p14c31355/psp3000-internal-mod/cad/references/orangepi-zero2w/opi24pin.png

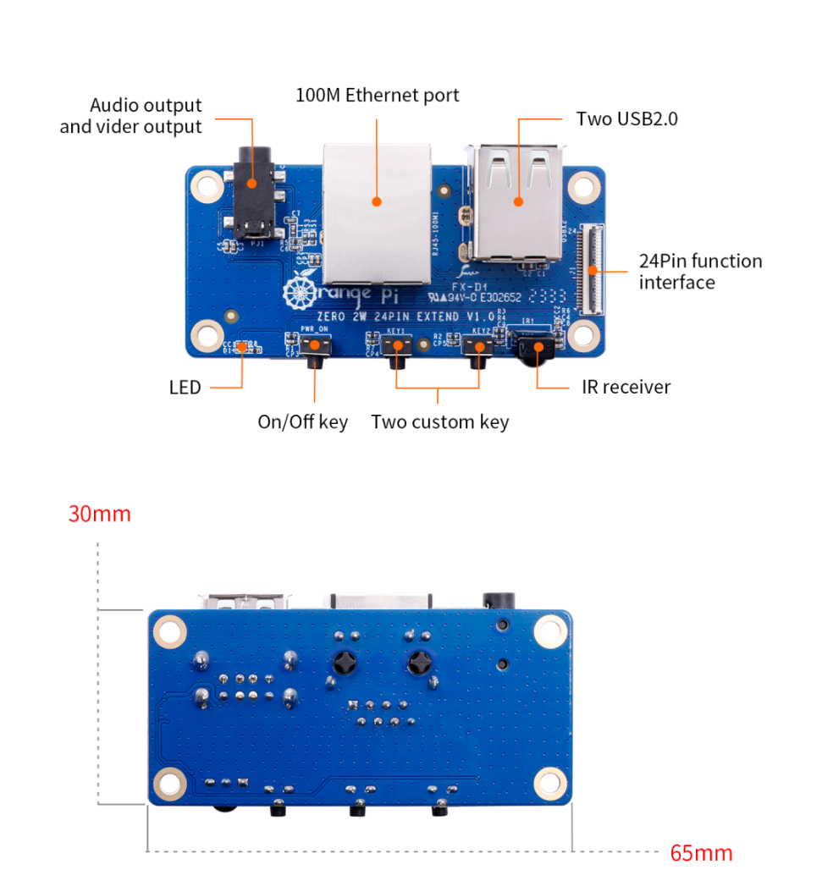
cad/references/orangepi-zero2w/opi24pin.png
