p14c31355/psp3000-internal-mod/README.md

# psp3000-internal-mod
PSP-3000 internal SBC, display adapter, power, USB-C, PCB and mechanical integration project.
