p14c31355/psp3000-internal-mod/docs/photo-analysis-donor-shell-drop2.md

# Donor shell photo analysis — drop 2 (2026-10-15 afternoon batch)

All 7 photos shot 2026-10-15 (13:50–14:00 JST), DOOGEE Note58 Pro,
4672x3504, mm stainless ruler in-frame throughout.  Files live in
`~/dev/p20-root/shots/` (not in repo).  All values PHOTO-ESTIMATED
(±2-3 mm through projection) unless marked otherwise.

## Shot inventory (drop 2)

| File | View | Key content |
|---|---|---|
| 135234_13722 | board side | MB, speaker left, UMD opening right (analyzed in drop 1) |
| 135241_13723 | battery side | battery bay, UMD cavity opening (drop 1) |
| 135248_13724 | **depth measurement** | ruler inserted vertically into the UMD bay opening, battery pack (PSP-S110 3.6V 1200mAh, label legible) still installed |
| 135255_13725 | **depth measurement #2** | ruler held vertically against the inner frame, reads ~30 mm at the white frame's depth edge |
| 140026_13726 | **skeleton FRONT shell** | clear replacement front face panel, new-in-bag, display window + button holes visible, width ~170 mm on ruler |
| 140033_13727 | skeleton front shell, other angle | same part; ribs and bosses visible THROUGH the clear plastic; central large circular rib structure |
| 140039_13728 | skeleton front shell, third angle | same part; blue circular ring accent at center, ~Ø50 mm at the 50–100 mm band |

## Findings

### 1. Depth measurements (U1/U2 — first real numbers)

- **13724**: ruler zero at the table plane, the 20 mm mark aligns with
  the body's rear outer surface → total body thickness ~19-20 mm,
  consistent with the 18.6 mm spec (photo-projection tolerance).  The
  lower part of the ruler (0-15) is inside the UMD bay — the visible
  numbers resume only above the shell.  This shot establishes the
  method works; a dedicated depth-of-cavity shot (0 at cavity floor,
  number at the door-trough ceiling) is the missing variant.
- **13725**: ruler against the inner frame reads the white chassis
  depth at **~30 mm band edge ≈ 30 mm** — this is the inner frame's
  vertical extent at that point, i.e. the internal z-space at the
  battery-side region is on the order of the spec's interior height.

### 2. Skeleton front shell (replacement, new) — high value for U12/U13

- Clear reproduction front panel confirmed purchased and in hand.
- **Display window**: large rounded rectangle, centered; edge
  reflections prevent exact bezel-width reading from these angles.
- **Internal structure visible through the clear plastic**: grid ribs
  and cylindrical bosses; a large **circular rib structure at the
  center** (13727) and a **blue circular ring accent ~Ø50 mm**
  (13728) at the 50-100 mm ruler band.
- Body width ~160-170 mm consistent across all three skeleton shots.
- SONY logo appears reversed through the clear plastic (viewed from
  the inside).
- Mechanical value: the skeleton's rib/boss pattern, seen from
  outside, gives the front-shell internal structure map without
  disassembly — the U12 aperture depth and U13 bezel questions can be
  narrowed with a straight-on window close-up + a ruler lying across
  the window edge.

### 3. Battery pack (13724)

- Label legible: **PSP-S110, 3.6 V, 1200 mAh, SONY** — the pack family
  is confirmed exactly (was previously "S110 class" inference).
- Pack still installed during the depth measurement.

## Updated measurement asks

1. **Cavity depth shot, done right**: ruler zero INSIDE the UMD cavity
   at its floor, reading at the door-trough ceiling plane (13724 got
   the method but the scale inside was hidden — retry with the ruler
   pushed so a graduation lands at the floor, or use the skeleton
   shell as a straightedge).
2. **Display window straight-on close-up** through the skeleton shell
   with the ruler across the window edge (bezel width + window W×H)
   — U13.
3. Same shot series with the ruler against the window's inner step if
   visible — U12.

All findings above are recorded as ESTIMATED; no manufacturing
constraint uses them yet.
