p14c31355/psp3000-internal-mod/cad/params.md

# PSP-3000 mechanical parameters (single source of truth for CAD)

Conventions:
- Units: millimeters.
- Coordinate system: X right, Y up, origin at bottom-left corner of the
  front face (LCD side), Z toward viewer (out of the screen). Body outline
  = the outer silhouette projected on XY.
- Every value carries provenance class:
  VERIFIED_FROM_PRIMARY_SOURCE (VPS) / VERIFIED_FROM_RELIABLE_SOURCE (VRS)
  / MEASURED / DERIVED / ESTIMATED / UNKNOWN.
- This file is consumed by cad/psp3000_model.py. Values marked ESTIMATED
  or UNKNOWN are rendered as explicitly flagged geometry or left hollow;
  they never silently become manufacturing constraints.

## Body envelope

param | value | class | source
---|---|---|---
BODY_W | 169.4 | VPS | Sony/SCEE PSP-3000 official product overview (WxDxH 169.4x18.6x71.4)
BODY_D | 71.4 | VPS | same
BODY_H | 18.6 | VPS | same (excludes largest projection)
BODY_CORNER_R | 6.0 | ESTIMATED | rounded-corner radius, visual estimate; refine from donor photos
SHELL_T | UNKNOWN | UNKNOWN | wall thickness, needs donor measurement (U1)

## LCD module (panel only; face glass/bezel separate)

param | value | class | source
---|---|---|---
LCD_W | 103.6 | VPS | Sharp LCM-09006 Table 5
LCD_H | 64.35 | VPS | same
LCD_T | 2.2 | VPS | same
LCD_ACTIVE_W | 95.04 | VPS | same
LCD_ACTIVE_H | 53.856 | VPS | same
LCD_X | UNKNOWN | UNKNOWN | X position of panel center; needs donor measurement (U1/m1.6)
LCD_Y | UNKNOWN | UNKNOWN | Y position of panel center; same
LCD_FPC_EXIT | UNKNOWN | UNKNOWN | which edge + position the 31-pin FPC exits; donor photo (m1.6)

## Battery

param | value | class | source
---|---|---|---
BAT_W | 58.7 | VRS | vendor listing PSP-S110 (2.31 in)
BAT_D | 36.0 | VRS | vendor listing (1.42 in)
BAT_T | 10.2 | VRS | vendor listing (0.4 in)
BAT_POS | UNKNOWN | UNKNOWN | battery pocket position; donor (m1.5)

## UMD cavity

param | value | class | source
---|---|---|---
UMD_CAVITY | UNKNOWN | UNKNOWN | full extent after drive removal (U2); donor measurement campaign 1
UMD_DOOR_CLEAR | UNKNOWN | UNKNOWN | min clearance to closed door (U2)

## Screw bosses

param | value | class | source
---|---|---|---
BOSS_XY | UNKNOWN | UNKNOWN | list of standoff XY positions (U3); donor
BOSS_DIA | UNKNOWN | UNKNOWN | standoff bore diameter

## Candidate SBC (Radxa ZERO 3W) — V1.11, primary-source extracted

Source: official Radxa 2D DXF (v1.11.0 top), 3D STEP, product brief.
Stored under cad/references/radxa-zero3w/. DXF circle extraction + STEP
bounding-box verified in FreeCAD (2026-10-13).

param | value | class | source
---|---|---|---
SBC_W | 65.00 | VPS | DXF X extent 0.00..65.00
SBC_D | 30.00 | VPS | DXF Y extent (30.21 incl. silkscreen overhang; board 30.0)
SBC_HOLE_PITCH | (3.55,3.6) (3.6,26.45) (61.4,3.6) (61.4,26.5) | VPS | DXF CIRCLE r=1.41 (4x mounting holes)
SBC_HOLE_R | 1.41 | VPS | same
SBC_H_MAX | 8.5 (with 40-pin header) / 3.5 budget (header unpopulated) | DERIVED | STEP z-profile, see cad/references/radxa-zero3w/height-profile.txt
SBC_STACK_BELOW | -4.5 max below board plane (USB-C/microHDMI edge) | DERIVED | same

## TA-090 motherboard (donor board) — iFixit photo-derived estimates

Source: iFixit PSP 300x Teardown (guide 1298), step-21 photos of the
removed TA-090v1 board (fetched 2026-10-13 via the iFixit guide API;
images under /tmp cache, re-fetchable).  All values ESTIMATED from
perspective-distorted photos with no scale reference; they may inform
exploratory keepouts only and must be replaced with MEASURED values
before any fit claim (U1-U3 remain UNKNOWN).

param | value | class | source
---|---|---|---
MB_SHAPE | L-shape: main body + narrow right arm | ESTIMATED | iFixit step-21 photo (board outline is an irregular rectangle with a long arm to the right, not a plain rectangle)
MB_BODY_RATIO_W_D | ~1.3:1 (main body, width:depth) | ESTIMATED | same, perspective-corrected +-5%
MB_ARM_FRACTION | arm length ~0.6-0.8x body width | ESTIMATED | pixel ratio analysis of step-21_17264.jpg
MB_ARM_WIDTH_FRACTION | arm width ~0.2-0.25x body depth | ESTIMATED | same
MB_SCREWS | 2-3 plated holes on left edge (top/bottom corners), arm fixed via sub-board connector | ESTIMATED | same
MB_CUTOUTS | large rectangular openings on the left edge (button contacts exposed through the board), curve cutout bottom-center | ESTIMATED | same
MB_WLAN | wireless module sits on the arm end, under a metal shield | ESTIMATED | same
MB_LCD_FPC | wide ZIF connector under the SoC shield, board left-center | ESTIMATED | same

Derived implication for the mod: the stock board's L-shape leaves the
UMD-cavity region (right, above the arm) free in the Z stack; our
replacement PCBs should target the same main-body zone plus the cavity,
not a single full-width rectangle.
