p14c31355/psp3000-internal-mod/docs/phase7-status.md

# Phase 6 completion status and Phase 7 kickoff plan

Updated: 2026-10-13, branch `feat/phase1-requirements-mech-truth`.

## What Phase 6 delivered

| Artifact | State | Verification |
|---|---|---|
| `pcb/power-board/power-board.kicad_sch` | Complete (USB-C, BQ25895, DW01A+Q1, TPS62130, J2/J3, R1-R12, C1-C2) | ERC **0 violations** |
| `pcb/power-board/power-board.kicad_pcb` | 17 footprints placed, fully routed (headless freerouting), GND zones both layers | DRC **2 exceptions** (documented), **0 unrouted** |
| `exports/power-board.step` | Exported | U3 model gap recorded (U10) |
| `scripts/gen_power_board.py` | Schematic generator (stage-based, library-truth pins) | reproducible |
| `scripts/gen_power_board_pcb.py` | Placement generator (netlist-driven) | reproducible |
| `scripts/pipeline-power-board.sh` | Full routing pipeline (DSN patch -> freerouting -> SES import -> fixups) | reproducible |
| `scripts/postroute_power_board.py` | Via widen / zone refill / GND stitching | reproducible |

## Open items carried forward

1. **DRC 2 clearance exceptions** — root cause is freerouting 1.6.2
   computing via clearances against the unpatched 0.4 mm padstack.
   Accepted with rationale (`docs/drc-exceptions-power-board.md`);
   superseded automatically when the board is re-placed onto the
   measured envelope and re-routed.
2. **U10** TPS62130 3D model missing from the KiCad library.
3. **U9** F32Q connector 3D model requires manual vendor download.
4. **SBC-side connections** (USB D+/D-, I2C, STAT/EN33) land on J3 —
   the harness definition to the Radxa is a Phase 7 deliverable.

## Phase 7 (mechanical/electrical co-design) entry conditions

Per AGENTS.md, every PCB revision gate needs STEP export plus an
interference check against a measured, aligned enclosure solid.  The
enclosure solid does not exist yet:

- Phase 2 keepout model is blocked on U1-U3 donor measurements
  (physical device or donor board required).
- Until then, the power-board STEP can only be checked against the
  Sony-published outer envelope, which is already encoded in
  `cad/psp3000_model.py` and `cad/sbc_stack_probe.py`.

## Next highest-value actions (in order)

1. Re-run `cad/sbc_stack_probe.py` with the power board's *actual*
   routed extents to confirm the UMD-cavity stack still fits the
   exploratory envelope (uses only verified outer dims).
2. Define the J3-to-Radxa harness pin map in
   `docs/harness-j3-radxa.md` (drives both the SVDI breakout and the
   power board's open I2C/USB nets).
3. When a donor board is available (owner decision): measure U1-U3/U5,
   re-place both boards onto the measured envelope, re-route, re-run
   the full gate.
