p14c31355/psp3000-internal-mod/cad/references/radxa-zero3w/radxa_zero_3w_v1110_top.dxf

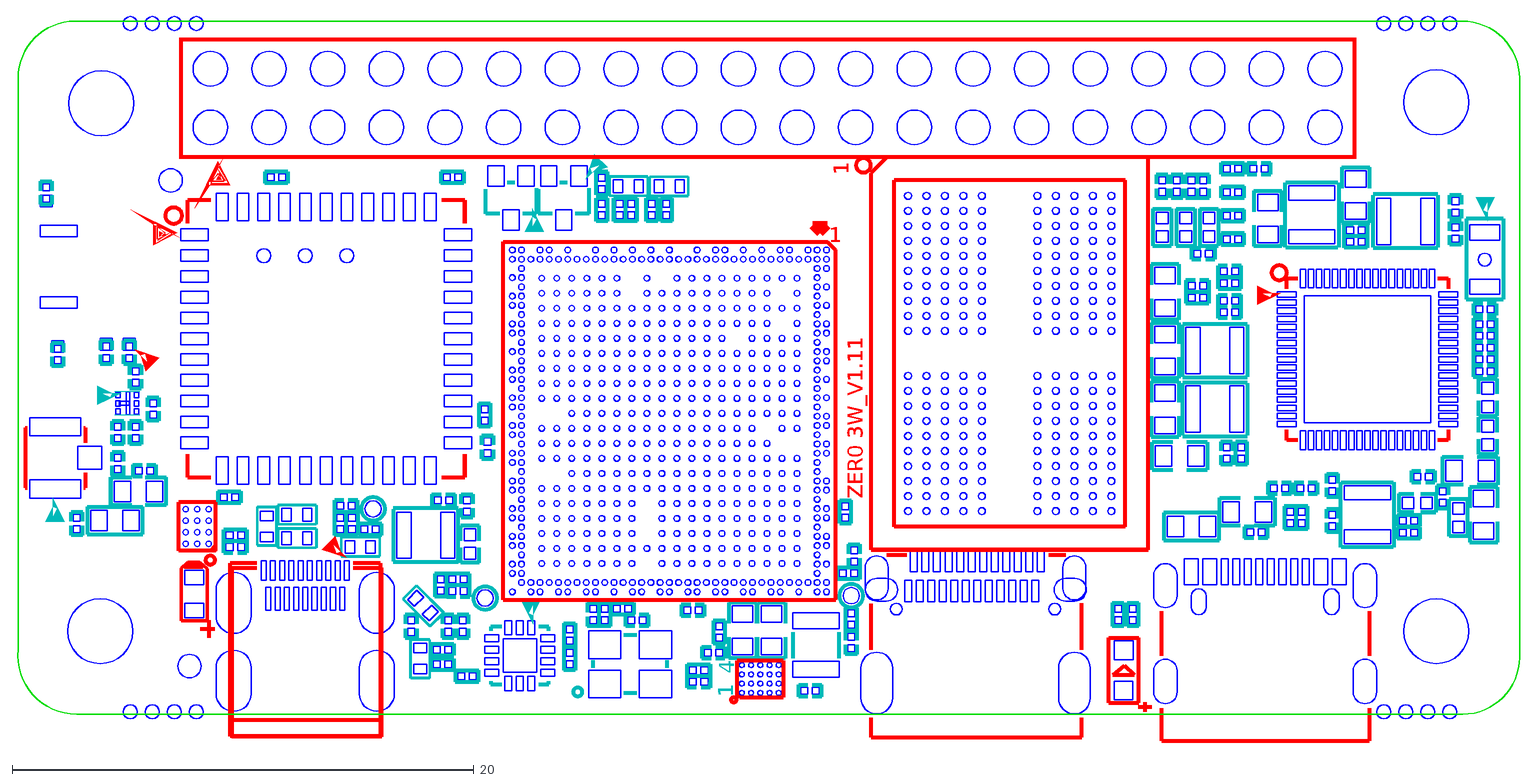
[picture p3: CAD file, 2026-10-13]
cad/references/radxa-zero3w/radxa_zero_3w_v1110_top.dxf
1
4
ZER0 3W_V1.11
