p14c31355/psp3000-internal-mod/cad/steps/umd_cut_study_v1.step

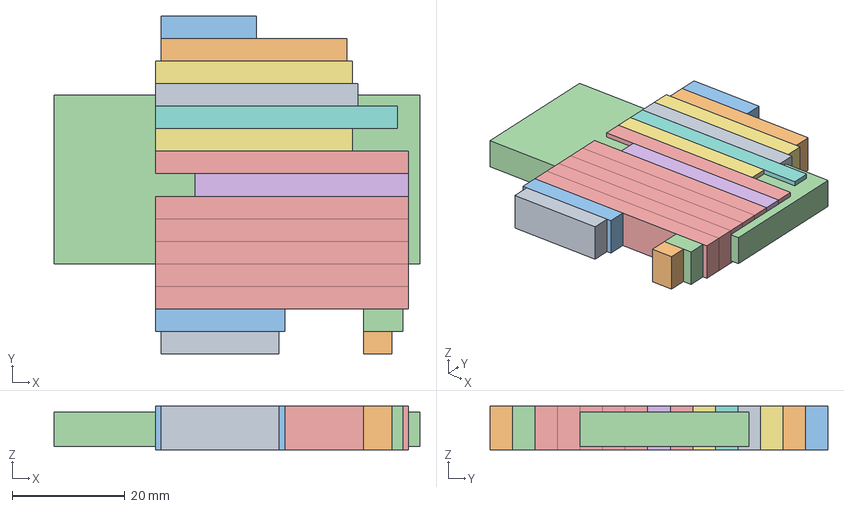
[picture p4: CAD file, 2026-10-15]
cad/steps/umd_cut_study_v1.step
65.0 x 60.0 x 7.73 mm
OPi_levelA
