p14c31355/psp3000-internal-mod/cad/steps/psp3000_keepouts_refscan.step

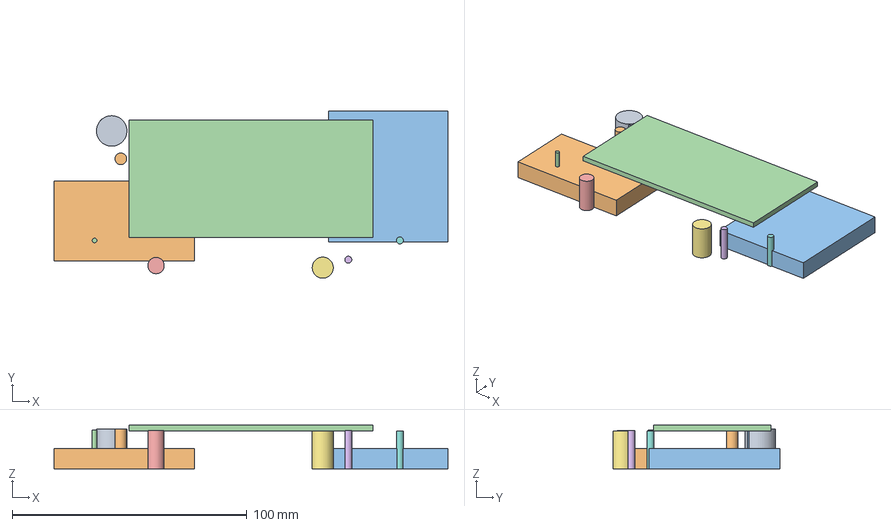
[picture p5: CAD file, 2026-10-15]
cad/steps/psp3000_keepouts_refscan.step
168.0 x 71.4 x 18.6 mm
boss_0
boss_1
boss_2
boss_3
boss_4
boss_5
boss_6
boss_7
boss_8
battery_bay
umd_cavity
glass_datum
