p14c31355/psp3000-internal-mod/cad/steps/orangepi_zero2w_envelope.step

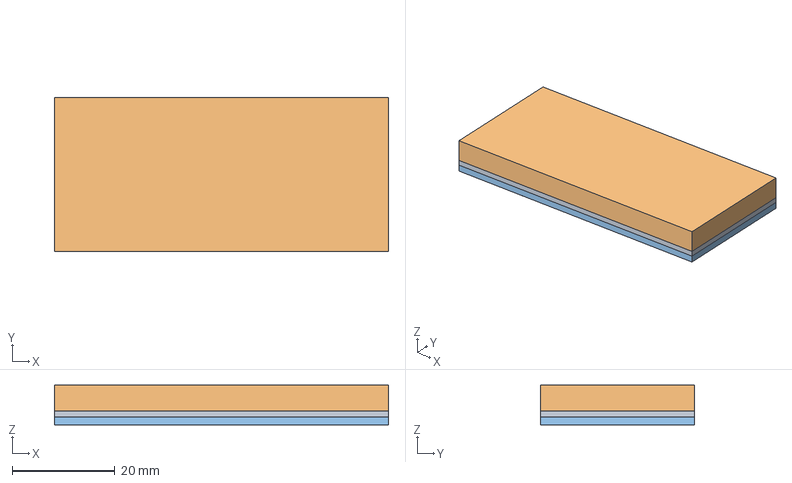
[picture p6: CAD file, 2026-10-15]
cad/steps/orangepi_zero2w_envelope.step
65.0 x 30.0 x 7.70 mm
board_cut3
top_envelope
bottom_envelope
