p14c31355/psp3000-internal-mod/pcb/power-board/power-board.kicad_pcb

## KiCad design pcb/power-board/power-board.kicad_pcb (2026-10-13)

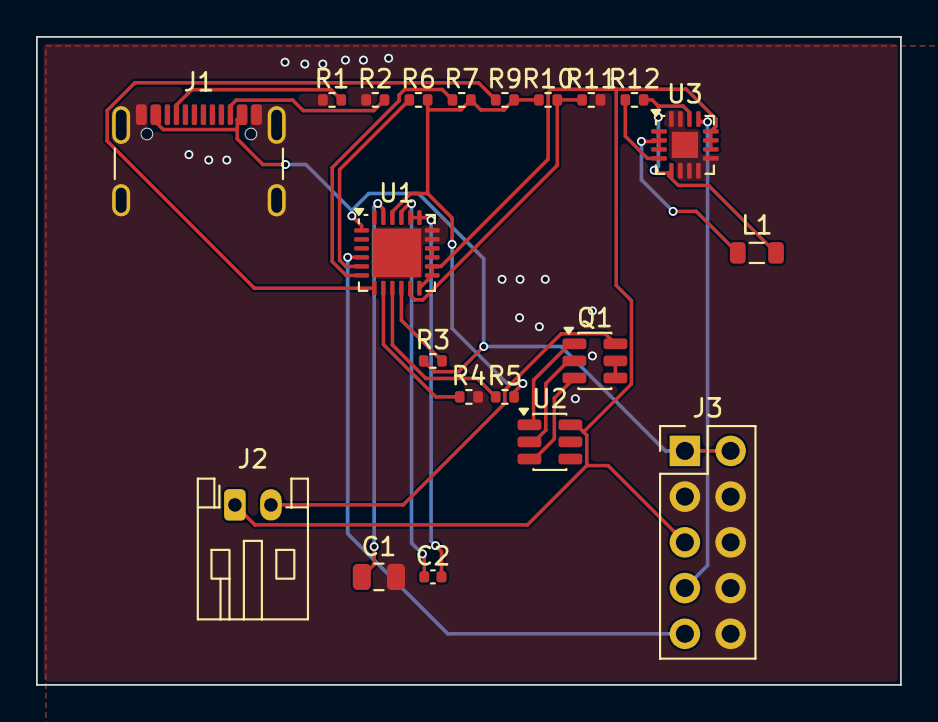
[picture p7: board power-board.kicad_pcb from above]

Board: 2 copper layers, 48.0 x 36.0 mm, 21 parts (0 on the bottom side), 27 nets.

Parts:
C1: C_0805_2012Metric
C2: C_0402_1005Metric
J1: USB_C_Receptacle_GCT_USB4105-xx-A_16P_TopMnt_Hori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; USB_C_Receptacle_GCT_USB4105-xx-A_16P_TopMnt_Horizontal
J2: JST_PH_S2B-PH-K_1x02_P2.00mm_Horizontal
J3: PinHeader_2x05_P2.54mm_Vertical
L1: L_0805_2012Metric
Q1: SOT-23-6
R1, R2, R3, R4, R5, R6, R7, R9, R10, R11, R12: R_0402_1005Metric
U1: Texas_RTW_WQFN-24-1EP_4x4mm_P0.5mm_EP2.7x2.7mm
U2: SOT-23-6
U3: VQFN-16-1EP_3x3mm_P0.5mm_EP1.45x1.45mm

Connections:
/BAT: J2.1, J3.5, U1.12, U1.13, U1.14, U2.6, U3.10, U3.11, U3.12
/BATGND: Q1.2, U2.2
/BTST: C2.1, U1.21
/CC1: J1.A5, R1.2
/CC2: J1.B5, R2.2
/CE: R5.1, U1.9
/EN33: J3.7, U3.13
/FETMID: Q1.4, Q1.5
/ILIM: R3.2, U1.10
/INT: R9.1, U1.7
/OTG: R4.1, U1.8
/PACKNEG: J2.2, Q1.6
/PG33: R12.1, U3.4
/PMID: C1.1, U1.23
/PROT_OC: Q1.3, U2.3
/PROT_OD: Q1.1, U2.1
/REGN: R5.2, R6.2, R7.2, R9.2, R10.1, U1.22
/SCL: R6.1, U1.5
/SDA: R7.1, U1.6
/STAT: J3.9, U1.4
/SW: C2.2, U1.19, U1.20
/SW33: L1.1, U3.1, U3.2, U3.3
/SYS: U1.15, U1.16
/TS: R10.2, R11.1, U1.11
/VBUS: J1.A4, J1.A9, J1.B4, J1.B9, J3.1, J3.2, R3.1, U1.1
/VOS33: L1.2, R12.2, U3.5, U3.14
GND: C1.2, J1.A1, J1.A12, J1.B1, J1.B12, J1.SH, J3.3, J3.4, J3.6, J3.8, J3.10, R1.1, R2.1, R4.2, R11.2, U1.17, U1.18, U1.25, U3.6, U3.7, U3.8, U3.9, U3.15, U3.16, U3.17
