p14c31355/psp3000-internal-mod/(commit log)

2026-10-12 Set up KiCad and agent development environment
2026-10-12 Require KiCad and FreeCAD design verification gates (#1)
2026-10-12 Phase 1: requirements, evidence for LQ043T3LX02 panel, unknowns register, measurement plan
    - docs/ARCHITECTURE.md: subsystem requirements (MUST/SHOULD/OPTIONAL/OPEN), v0.2 block diagram
    - docs/evidence/lcd-LQ043T3LX02.md: primary-source extraction (Sharp LCM-09006):
    pin map 31-pin LCD FPC (SVDI CLK/DATA1/DATA2 pairs), rails VCC/VS/VGH/VGL,
    backlight 7-LED series, power sequencing, Samantha register interface
    - docs/UNKNOWNS.md U1-U8: measured-value blockers with exact procedures
    - docs/MEASUREMENT-PLAN.md: donor measurement campaigns 1-3
    - docs/decisions/lcd-reuse.md: Option A (FPGA SVDI bridge) provisional,
    gated on SVDI symbol packing capture (U6)
    - docs/references/LQ043T3LX02_datash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
2026-10-12 Phase 2/3: parameterized mechanical model skeleton, SBC candidate evaluation
    - cad/params.md: provenance-tagged parameter table (VPS/VRS/ESTIMATED/UNKNOWN)
    consumed by the CAD builder; UNKNOWN never silently becomes a nominal
    - cad/psp3000_model.py: headless FreeCAD builder emitting body envelope,
    provisional LCD module, placeholder keepout footprints; verified solids
    (body 169.4x71.4x18.6, lcd 103.6x64.35x2.2) and fixed corner-arc defect
    - docs/sbc-evaluation.md: Radxa ZERO 3W primary candidate with sources,
    frozen comparison criteria, RGB888 path open issue, rejected list
2026-10-12 Phase 3: primary-source SBC geometry, height profile, stacking probe
    - cad/references/radxa-zero3w/: official Radxa v1.11 DXF/STEP/product brief
    - DXF extraction: board 65.00x30.0, 4x mounting holes r=1.41 at
    (3.55,3.6)(3.6,26.45)(61.4,3.6)(61.4,26.5) -> VPS params in cad/params.md
    - STEP z-profile (tessellation method after boolean approach timed out):
    max 8.5mm with GPIO header, 3.0-3.5mm budget without, -4.5mm below at
    USB-C/microHDMI edge -> cad/references/radxa-zero3w/height-profile.txt
    - cad/sbc_stack_probe.py: fixed probe semantics (envelope = allowed volume;
    outside=cut volume, LCD clash=common volume). Rotated-90 placement fits
    with zero outside volume at 3 positions; iden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
    [radxa_zero_3w_v1110_top.dxf]
2026-10-12 Phase 4: SVDI capture breakout schematic (ERC clean, KiCad-verified)
    - scripts/gen_svdi_breakout.py: deterministic generator; symbol defs are
    extracted verbatim from the installed KiCad standard library and renamed
    to lib-qualified form (Connector_Generic:Conn_01xNN) inside lib_symbols
    - pcb/svdi-breakout/: 31-pin 0.5mm FPC (panel Table 6-3 pin map) -> 1x40
    1.27mm capture header; header pins 32-40 flagged no_connect
    - pin geometry uses the real library symbol coordinates (pin 1 at top,
    screen Y grows downward); verified by ERC: 0 violations
    - netlist sanity: 34 nets, COM net joins J1.1 / J2.1 as expected
    - ERC run: kicad-cli sch erc --severity-all -> exit 0, 0 violations
    [svdi-breakout.kicad_sch]
2026-10-12 Phase 4: SVDI breakout PCB, DRC clean through full verify gate
    - scripts/gen_svdi_breakout_pcb.py: deterministic headless pcbnew generator
    (netlist-driven pad-net binding, board outline, GND pour)
    - Routing v5 (layer-split switchbox): F.Cu vertical stubs per J1 pad (0.5 mm
    pitch, via1 0.35/0.2 at y=41.5), B.Cu verticals to stepped rows via2,
    F.Cu horizontals at each net's J2 pad row landing on the plated pad, and
    F.Cu upper ties for multi-pin nets (COM/NC/VS) with span-ordered stagger
    (widest span highest) so no tie crosses another net's stub
    - Geometry verified against DRC iteratively; constraints for this bench
    board written to board.design_settings.rules in the project file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
    [svdi-breakout.kicad_pcb, svdi-breakout.kicad_sch]
2026-10-12 Phase 5: power architecture working notes
    - docs/phase5-power-notes.md: evidence from hackaday S110 teardown
    (proprietary PMIC 16808C18SC, console refuses generic packs, donor cell
    into original PMIC keeps all functions), consequences for our design,
    Q6/Q7 open questions, proposed BQ25895-class subsystem block
    - Default working assumption: full console-board removal -> we own the
    pack contacts and need our own 1S charger + protection (M4)
2026-10-12 Phase 3/5: Radxa ZERO 3W v1.12 official schematic PDF added as reference
    Primary source for the SBC interface design (GPIO mux, RGB-capable pins,
    power tree) when Phase 5 finalizes the SBC-to-bridge connection.
2026-10-12 Phase 5/6: power parts verification with primary datasheets
    - docs/evidence/: BQ25895, TPS62130, DW01A datasheets downloaded
    - docs/evidence/power-parts-pinout-verification.md: BQ25895 package is
    WQFN-24 (RTW) 4x4mm EP2.7x2.7 - corrected from earlier VQFN-20 draft;
    footprint Texas_RTW_WQFN-24-1EP_4x4mm_P0.5mm_EP2.7x2.7mm verified to
    exist. TPS62130 = VQFN-16 3x3 (RGT), EP mandatory. DW01A SOT-23-6.
    - docs/phase6-power-bom-notes.md: component selection record
    (USB-C 16P GCT USB4105, BQ25895, DW01A+dual NMOS, TPS62130 3A buck,
    JST PH S2B battery connector) with library refs and open items
2026-10-12 Phase 5/6: BQ25895 pin map and design constants from datasheet
    - docs/evidence/bq25895-pinmap.md: full pin table (primary source),
    OTG/PMID capacitance rules, ILIM resistor calc (KILIM 390 typ),
    open item on SYS voltage range vs Radxa 5V input spec
2026-10-12 Phase 5/6: power architecture resolved against datasheets
    - Radxa ZERO 3W takes a regulated 5V single rail (+5V_INPUT from USB-C
    VBUS and GPIO header pins 2/4, RK817-5 PMIC) - primary source v1.12
    schematic
    - BQ25895 OTG boost outputs 5V on VBUS (not PMID) - datasheet verified.
    Architecture: SBC 5V rail = VBUS node (USB-C input or OTG boost, one
    node both modes); SYS (follows battery) feeds only the 3.3V buck
    (TPS62130 input range 3-17V compatible)
    - PMID cap 60uF for OTG headroom; OTG pin from SBC GPIO
2026-10-12 Phase 6: power board schematic generation plan
    Symbol/footprint pairs for all six subcircuits, generation method
    (programmatic pin-coordinate parsing from library symbols), ERC notes
    (PWR_FLAG placement), validation gate = ERC 0 before PCB
2026-10-12 Phase 6: power board schematic generator, stage 1 ERC-clean
    scripts/gen_power_board.py generates pcb/power-board/ from KiCad
    library symbols with real pin geometry. KiCad 10 parser findings
    recorded in the generator:
    - symbol instance (instances) blocks need full nesting (project/path/
    reference/unit each closed); a self-closed (project) makes the
    schematic unloadable (erc exit 3)
    - missing lib symbol for an instance lib_id also fails the load
    - symbol pin (at) IS the connection point (length is inward)
    - all coordinates must sit on the 1.27 mm grid or endpoints go off-grid
    - footprint field nickname must be 'Lib:Footprint' (no .pretty)
    Stage 1: USB-C receptacle + CC 5.1k pulldowns + PW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
    [power-board.kicad_sch]
2026-10-13 Phase 6: power board schematic complete, ERC error-free
    Full power architecture captured in pcb/power-board/:
    - J1 USB-C (16P) with 5.1k CC pulldowns, GND/SHIELD bus, PWR_FLAG on VBUS
    - U1 BQ25895RTW charger: BAT/SYS/SW/REGN/PMID/BTST nets, ILIM via R3
    196R (KILIM 390 typ -> ~2A input limit), OTG pulldown R4, CE pullup
    R5 to REGN, I2C/STAT/INT pullups R6-R9 to REGN
    - U2 DW01A + Q1 dual-NMOS pack protection in DW01A standard topology:
    PACKNEG(Q1.D1) -> FETMID(Q1.S1=D2) -> BATGND(Q1.S2), OD->G1, OC->G2
    - U3 TPS62130 3.3V buck: SW33->L1 2.2uH->VOS33, FB tied to VOS33,
    FSW/DEF/SS tied to GND, VIN=BAT, exposed pad on GND
    - J3 2x05 output header: VBUS, GND, BAT, EN33, STAT
    ERC: 0 errors (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
    [power-board.kicad_sch]
2026-10-13 Phase 6: power board PCB placed, ERC 0 / DRC 0, STEP exported
    pcb/power-board/power-board.kicad_pcb: 17 footprints placed (J1 USB-C,
    U1 BQ25895, U2 DW01A, Q1 dual FET x2 units, U3 TPS62130, L1, J2/J3,
    R1-R12, C1-C2), GND zone on B.Cu, KiCad-10 rule constraints in
    board.design_settings.rules (min_hole_clearance 0.15 for the USB-C
    shell NPTH geometry, min_via_diameter 0.4).
    Schematic fixes this round:
    - D+/D- and DSEL are explicit no-connects (charging-only, BC1.2 mux off)
    - J2.2 is PACKNEG: battery negative routes through the protection FETs
    (previous wiring tied it to BATGND, bypassing Q1)
    - C1 8.2uF PMID bypass, C2 47nF BTST-SW bootstrap, R10/R11 TS divider
    (bench bring-up; donor pack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
    [power-board.kicad_pcb, power-board.kicad_sch]
2026-10-13 docs: donor measurement substitute search results
    Searched psdevwiki (TA-090 board identity), SKU models, and vendor
    listings for TA-090 mechanical dimensions. Result: no public source
    carries PCB outline/holes/component heights. Shipping-box dims
    (178x80mm) only give an upper bound. docs/donor-substitutes.md
    records the search, what can be substituted non-dimensionally, and
    the single cheapest unblocking step: a pulled donor board purchase
    (owner decision, STOP condition payment-required).
2026-10-13 Phase 6: power board routed (0 unrouted), DRC 2 documented exceptions
    scripts/pipeline-power-board.sh: full reproducible routing pipeline -
    placement regen, GND zones (F.Cu+B.Cu, FULL connection), Specctra DSN
    export with via padstack patched to 0.5/0.3, headless freerouting
    1.6.2 (tools/, gitignored, single-threaded for determinism), GND strip
    from SES, import, post-route fixups (scripts/postroute_power_board.py:
    via widen, zone refill, GND stitching vias for F.Cu islands).
    Result: 0 unrouted nets; ERC 0; DRC has 2 clearance violations
    (via-track 0.080-0.106 mm), documented and accepted with rationale in
    docs/drc-exceptions-power-board.md - root cause is freerouting 1.6.2
    computing clearan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
    [power-board.kicad_pcb]
2026-10-13 docs: Phase 6 completion status and Phase 7 entry plan
    docs/phase7-status.md records the delivered artifacts, the open
    exceptions (DRC 2, U9/U10 models), and the ordered next actions:
    stack re-probe with real routed extents, J3-Radxa harness pin map,
    donor measurement campaign when a board is available.
2026-10-13 Phase 6: power board placement rev 3 (J1/J2/L1/R6-R9 repositioned)
    J1 USB-C moved to the top edge (its footprint body extends left of the
    origin), R6-R9 pullup bank to the top strip, L1 and J2 clear of J1.
    Placement changes force a re-route each time; the pipeline reproduces
    the full flow.
    postroute stitch placement now checks full track segments (mid-track
    crossings were missed before).
    DRC state on this revision: 5 violations (4 vias at 0.08-0.12 mm
    clearance from the 1.6.2 via-padstack limitation, plus 2 GND zone
    island ratsnest reports). Exception record updated in
    docs/drc-exceptions-power-board.md; ERC 0, 0 unrouted nets.
    [power-board.kicad_pcb]
2026-10-13 docs: J3-Radxa harness pin map and U11 (STAT level shift)
    docs/harness-j3-radxa.md maps the power board's J3 2x05 header to the
    Radxa ZERO 3W 40-pin header (5V on pins 2/4 per the product brief,
    I2C3_M0 on pins 3/5 for the charger's I2C). New unknown U11: the
    STAT pull-up rail (REGN 4.7 V) exceeds the Radxa GPIO 3.63 V maximum;
    resolution is an open-drain pull-up on the Radxa side, one schematic
    edit scheduled for the next revision.
2026-10-13 Phase 6: U11 fix applied (STAT pull-up moved to Radxa side), DRC state recorded
    - R8 (STAT 10k pull-up to REGN 4.7V) removed from the schematic:
    STAT is open-drain, its pull-up now lives on the Radxa side at
    3.3V per docs/harness-j3-radxa.md - prevents over-stressing the
    SBC GPIO (3.63V abs max). ERC stays 0.
    - PCB re-placed and re-routed through the pipeline. DRC settles at
    7 via-track clearance violations (0.08-0.12mm measured) - the
    freerouting 1.6.2 via-padstack limitation documented in
    docs/drc-exceptions-power-board.md; interactive via relocation
    confirmed locally-optimal (each move trades one violation for
    another).
    [power-board.kicad_pcb, power-board.kicad_sch]
2026-10-13 cad: TA-090 motherboard shape estimates from iFixit teardown photos
    iFixit guide-1298 step-21 photos (via guide API, 1600x1200) show the
    removed TA-090v1 board: an L-shaped outline (main body + narrow right
    arm ~0.6-0.8x body width), plated holes on the left edge, button-contact
    cutouts on the left edge, WLAN module on the arm end. All values
    ESTIMATED (perspective-distorted, no scale reference) - recorded in
    cad/params.md as exploratory keepout hints only; U1-U3 stay UNKNOWN
    until a donor board is measured.
2026-10-13 cad: co-stacking probe passes with Option C z-stack
    cad/costack_probe.py: Radxa (90deg CCW, x0=135, y0=6) now at z0=9.5
    (underside 5.0, header top 18.0 < 18.6 body); power board 48x36 mm
    (the largest rectangle inside the DERIVED 60mm UMD disc cavity) fits
    underneath at z0=1.0 with the USB-C shell top at 4.2 < 5.0 - PASS at
    six swept positions in the provisional UMD-cavity zone; USB-C solid
    also clear of the SBC footprint's populated area.
    Result recorded in exports/mech/costack_probe.txt. All values remain
    envelope-class ESTIMATED/DERIVED pending U1-U3/U2 donor measurements.
    cad/power_board_sizing_probe.py documents the 105x45 -> 48x36 resize
    requirement (105x45 diagonal 114mm cannot fit t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
2026-10-13 Phase 6: power board resized to 48x36 (UMD-cavity fit), placement rev 4
    Board outline 105x45 -> 48x36 mm: the largest rectangle inside the
    DERIVED 60mm UMD disc cavity (cad/power_board_sizing_probe.py). All
    21 footprints verified inside the outline by pad-extent check; J3
    rotated to vertical, Q1/U2/C1/C2/R6-R12 repositioned to clear
    courtyards and the J1 shield NPTH. Pipeline re-routed cleanly: 0
    unrouted nets, no shorts, no courtyard overlaps; remaining DRC state
    is 7 via-track clearances + 3 zone-island reports, same freerouting
    1.6.2 root cause, exception record updated. STEP re-exported.
    [power-board.kicad_pcb]
2026-10-13 docs: DRC exception record covers zone-island reports
    Verified interactively that adding more stitching vias at every clear
    spot still leaves 3 F.Cu<->B.Cu zone island reports - the pour
    fragments around the dense 0402 bank and each new via lands either on
    a track clearance or inside a fill cut-out. Recorded; both classes of
    remaining violations are scheduled to disappear with the measured
    envelope re-placement.
    [power-board.kicad_pcb]
2026-10-15 v2 kickoff: failure analysis of 48x36 prototype + Orange Pi Zero 2W primary references
    docs/failure-analysis-48x36.md: measured diagnosis - 9% pad copper
    density, 491mm track length for 21 parts, outline derived from a desk
    exercise not the enclosure, connector placements moved by DRC not by
    the shell, JST-PH battery assumption unverified vs stock S110, missing
    button-FPC and USB-C-cutout geometry. Usable carry-over: BQ25895
    topology + pinmap, DW01A+2FET protection, TPS62130, U11 decision,
    harness logic. Discard: outline, all placement/routing, single-board
    partition, 2x05 header as SBC interconnect, JST-PH battery assumption.
    cad/references/orangepi-zero2w/: official User Manual v1.1 (17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
2026-10-15 v2 display candidates: ST7262E43-class 4.3in 800x480 RGB panels + bridge comparison
    docs/display-candidates.md: 5 candidates with outline/thickness/fit vs
    the stock 103.6x64.35x2.2 window. Active area 95.04x53.856 matches
    exactly (same glass family as the stock panel). Provisional primary:
    CDTech S043BWV106EP (101.5x64.0 outline fits inside stock footprint);
    thickness 3.0-4.5mm exceeds the 2.2mm glass - blocked on U12 aperture
    depth measurement. Bridge: LT8619C (QFN76 9x9, HDMI->RGB TTL, on-chip
    EDID, datasheet archived) provisional for the compact board, TFP401A
    for the debug breakout. H618 has no parallel RGB output - the bridge
    is mandatory, recorded in the fit table.
2026-10-15 v2 system architecture: display datapath, ARK streaming analysis, supervisor FSM, power budget
    docs/system-architecture.md: H618 HDMI-only -> LT8619C -> RGB888 panel
    datapath decided (33MHz SDR, on-chip EDID, no EEPROM). ARK video: 3
    paths compared quantitatively - USB framebuffer streaming is primary
    (15.7MB/s raw @60fps fits USB2.0 trivially), FPGA SVDI capture
    rejected for rev1, dual-screen is the fallback; boot-graphics gap
    documented as accepted limitation, streaming PRX tracked as the top
    software risk. Supervisor: CH32V203 as input MCU + mode FSM (capture
    window 1.5s, flash latch, 2-bit strap, per-mode rail control), UART
    12-byte frame protocol. Power budget draft: 2.5A sustained /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
2026-10-15 v2 mechanical layout draft: UMD-cavity volume analysis + OPi placement study
    docs/mechanical-layout.md: OP-A (OPi flat in disc well) excluded
    arithmetically - max chord at 30mm offset is 51.96mm < 65mm, recorded
    so it is not re-derived. OP-B (split-z: well floor + trough) is the
    provisional selection pending U1/U2 cavity measurements; OP-C
    replaces the stock MB volume - rejected (ARK mode needs the stock MB);
    OP-D stacked above the MB - rejected by z-stack arithmetic (~4-6mm
    gap vs OPi component height). Display stack: module + bridge <=
    glass budget, the single biggest mechanical risk, unblocked only by
    U12. Six measurement requests consolidated (U1/U2/U12/U13/U14/U15);
    board outlines ex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
2026-10-15 v2 input architecture: interposer pass-through + supervisor scan, UART protocol frozen
    docs/input-architecture.md: CH32V203 supervisor on a button-FPC
    interposer - straight-through contacts for ARK (zero added latency),
    high-Z sense taps always, MCU drives its own matrix scan only when
    the PSP MB is powered off (drive FETs tri-stated in ARK mode), stick
    reference relay-or for OPi-only modes. 12-byte UART frame frozen for
    rev-1 hardware (buttons A/B/C bitmask + 12-bit stick + mode echo +
    XOR checksum, 10ms period). RP2040 rejected with reasoning (2x price
    and size, no USB/PIO need); CH32V003 rejected (flash headroom for FSM
    + latch + updater). ESD: TVS on all row/col taps. Blocked on U14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
2026-10-15 v2 power budget: rail map, endurance arithmetic, BQ25895 re-justification
    docs/power-budget.md: 8-load worst-case table (OPi 2A ceiling from
    official manual, backlight 27.2V/80mA VERIFIED, PSP MB ESTIMATED
    pending U16). Single VBUS-node architecture carried over (BQ25895
    OTG on VBUS pin, verified v1) - OTG 3.1A vs 2.7A combined load
    leaves 0.4A margin, fallback TPS61023 recorded if U16/bring-up shows
    sustained >2A. Endurance arithmetic honest: ARK mode ~29 min on
    1200mAh (OPi sink adds ~5W), recorded as known limitation with rev-2
    mitigation options, not hidden. BQ25895 retained (no cheaper
    charge+OTG+path in JLC Basic), DW01A+FET and TPS62130 blocks reused,
    LM2596S stays rejected. New p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
2026-10-15 v2 connector orientation rules: 7-point mandatory checklist
    docs/connector-orientation.md: born from the v1 failure (J1/J3 moved
    by DRC, cable contact side never recorded). Every connector needs
    datasheet numbering, footprint numbering, mate orientation, PCB side,
    cable contact side, assembled direction, and a 3D render check before
    its board's placement is 'done'. FFC conventions written down
    (top/bottom-contact definitions, conductor-side mirroring rule, 3mm
    bend radius). Board-to-board links L1/L2 pre-registered with TBD
    columns that must be filled at schematic time; panel FFC conductor
    side must come from the ordered part's drawing, not assumed.
2026-10-15 v2 unknowns register: U12-U18 added, U11 resolved-in-design
    U12 display aperture depth (top v2 blocker - panel 3.0-4.5mm vs stock
    2.2mm stack), U13 bezel lip, U14 button FPC matrix map, U15 OPi
    as-measured geometry (3.0mm hole dia VERIFIED, positions ESTIMATED),
    U16 stock MB current profile, U17 pack ID/thermistor, U18 OPi 24pin
    FFC pin map (manual capabilities VERIFIED, per-pin map pending
    reliable image read + donor confirmation). U11 STAT level shift is
    RESOLVED-IN-DESIGN with the v1 board retirement.
2026-10-15 measurement plan v2: campaign 4 for donor measurements, SVDI deprioritized
    Campaign 4 (m4.1-m4.7) maps each new UNKNOWN to a concrete donor
    measurement with method and what it unlocks; priority order m4.1
    (aperture depth) -> m4.3 (cavity) -> m4.2 (button FPC) -> m4.4/m4.5
    (OPi geometry+FFC) -> m4.6/m4.7. Campaign 3 SVDI capture
    deprioritized - v2 replaces the stock panel so U6 leaves the critical
    path, retained only as the ARK-streaming fallback.
2026-10-15 OPi Zero 2W mechanical envelope model + STEP
    cad/opi_zero2w_envelope.py generates a placeholder envelope from
    verified dims only (65x30x1.2, holes d3.0) with ESTIMATED hole
    positions (3.5mm inset, RPi Zero family pattern) and component
    envelopes (5.0mm above / 1.5mm below) - explicitly marked U15
    pending, not a fit claim. STEP round-trip verified in freecadcmd:
    board 65.0x30.0x1.2, envelopes 5.0/1.5 as designed.
    [orangepi_zero2w_envelope.step]
2026-10-15 OPi Zero 2W reference images: interface detail + 24pin extend board photo
    Wiki images archived for U18 (24pin pin map) and placement study;
    interface callouts: audio+AV jack, 100M eth, USB2.0 x2, 24pin edge,
    on/off + 2 custom keys (LRADC), IR receiver.
2026-10-15 donor shell photo analysis drop 1: UMD cavity, battery interface, speaker
    docs/photo-analysis-donor-shell.md: 4 photos (2 from 10-13, 2 from
    10-15, mm ruler in-frame) analyzed. Key photo-estimated findings:
    UMD cavity opening is a rounded near-square ~50mm across (not the
    full Ø60 circle - the inscribed-circle model overstated one axis);
    drive already removed, MB visible through the cavity floor (OP-B
    split-z stays plausible only above floor / below door trough);
    battery pack connects via a gold-contact plate on a small PCB at the
    bay's upper edge, NOT a JST harness - U17 narrowed to contact-plate
    geometry; speaker = round, left side, ~20+mm ESTIMATED; ~6 screw
    bosses visible plus cavity/b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
2026-10-15 donor shell photo analysis drop 2: depth shots + skeleton front shell
    docs/photo-analysis-donor-shell-drop2.md: all 7 photos from the
    10-15 afternoon batch analyzed. Depth method proven (ruler zero at
    table, 20mm mark at rear surface = ~19-20mm body thickness,
    consistent with spec); inner frame z-extent reads ~30mm at the
    battery-side region. Skeleton (clear reproduction) FRONT SHELL
    confirmed in hand - ribs/bosses visible through the plastic, display
    window + blue center ring ~50mm; a straight-on window close-up with
    the ruler can now answer the bezel half of U12/U13 without
    disassembly. Battery pack label legible: PSP-S110 3.6V 1200mAh
    exact family confirmation. U12 updated with the sk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
2026-10-15 mechanical reference: BitBuilt PSP-3000 scan analysis + xovi kit guide text
    docs/scan-reference-bitbuilt.md: downloaded Wesk's 3rd-party PSP-3000
    scan set (4 meshes, 0.8-1.25M tris each, 433MB - gitignored,
    re-downloadable). Scale validated: 168.2mm X vs 169.4 spec (~1%).
    Z-profile findings: rear UMD-cavity rim band 8.8-14.4mm, battery bay
    rim ~4.2mm, 12 boss clusters >16mm (tallest 17.35mm), UMD lid is a
    thin shell (z 0-1mm dominant) so the depth budget is the door-trough
    walls not the lid. Front scanned WITH glass: continuous 2.2-2.8mm
    plateau = glass outer profile (U12 stack input); the display window
    is a color boundary not a Z boundary - window XY stays with the
    skeleton photos (U13).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
2026-10-15 scan alignment + UMD cavity probe (first usable-volume numbers)
    cad/align_scans.py: body coordinate system established (origin
    front-face bottom-left, rear outer face = z0 datum); rigid transforms
    only (front dz=+5.398 anchoring the glass at z=18.6 spec); rig offset
    1.1mm x / 2.7mm y recorded; seam assumption explicit in
    alignment.json.
    cad/umd_cavity_probe.py + json: 1mm zmax top-map of the aligned rear
    mesh. UMD cavity deep-visible opening: x 118-168, y 12-66 (50x54mm,
    1675mm2, eq circle 46.2mm, centroid 142/36); visible floor z 1.27-3.08
    (median 1.55); rim band z 7.7-9.9 (median 8.73). Interpretation
    recorded: the full cavity extends under the door trough beyond the
    visible band - the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
2026-10-15 UMD cavity probe v2: door-trough extension added
    The battery-side deep-visible band (v1) under-measured the cavity: the
    door-trough channel (y 58-70, x 117-155, z 1-3) is a continuous deep
    region. v2 separates main opening (47x50mm, 1591mm2, eq circle 45mm,
    centroid 142/36) from the trough extension (253mm2); total deep region
    1798mm2 / eq circle 47.8mm. UMD lid confirmed ~1.4-2mm thin shell ->
    trough depth is set by rear-shell walls, not the lid. OP-B
    implication recorded: 5mm component envelope vs rim z~8.7 leaves
    ~2-3mm headroom per level; cut study still needed for the door-side X
    extension.
2026-10-15 keepout solids + first OP-B FreeCAD interference check
    cad/build_keepouts.py: 9 boss cylinders (from the >16mm raster
    clusters), battery bay 60x34, UMD cavity 51x56 (main+trough
    footprint), glass datum 104x50x2.5 - exported to
    cad/steps/psp3000_keepouts_refscan.step, round-trip verified (12
    labeled solids).
    cad/opb_placement_check.py + docs/opb-placement-study.md: OPi level-A
    (65x30, board z 1.55-2.75, components to 7.75, x 103-168, y 24-54)
    clears all 9 bosses (worst 13.80mm) and the battery bay (43mm); 78%
    inside the cavity box, 22% = the 14mm x-overhang onto the battery-bay
    side whose occupancy is the open question. Headroom arithmetic: top
    7.75 vs rim 8.73 = 0.98mm - tight, U15 compone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
    [psp3000_keepouts_refscan.step]
2026-10-15 donor photo drop 3: two depth-measurement shots, readings pending face confirmation
    13730: tape measure into the cavity, bend at the 40 graduation (0 end
    hidden inside). 13731: steel ruler into a rectangular recess, face
    aligns ~20mm. Cross-checks recorded: 40mm insert is plausible for a
    partial Y-depth of the 50mm opening; the 20mm recess does NOT match
    the UMD cavity z band (7-8mm expected) - likely a different pocket or
    a table-zero thickness read matching the 13724 method. Both numbers
    become real donor measurements once the user confirms which faces the
    zero and the reading refer to.
2026-10-15 UMD door-side depth confirmed: lid inner face to bottom structure ~20mm
    User confirmed the 13731 reading: ruler zero = UMD lid's inner face,
    so 20mm is the donor-measured door-side span. Cross-check: lid is a
    1.4-2mm thin shell, lid inner face sits under the rim band (z 7.7-9.9);
    20mm reaches past the visible floor level (1.3-3.1) - the cavity is
    deeper on the door side than the battery-side rim implied. OP-B
    confidence upgraded: second level under the lid has real room (board
    1.2 + components 5.0 = 6.2mm fits with large margin); the next read is
    what the ruler landed on (disc-well floor vs drive-mount bracket -
    bracket would be UMD-mechanism-only and cuttable). U2 updated to
    PARTIALLY ME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
2026-10-15 correction: 20mm read was a wiring-hole chord, scan stays authoritative; cut study authorized
    User corrected the 13731 interpretation: the ruler went through the
    UMD drive wiring hole on the joystick-side face - the 20mm is a chord
    read along that hole axis, not a door-side cavity depth. The scan
    values (opening 47x50, rim z 8.7, floor 1.3-3.1) remain authoritative
    for cavity geometry; the 20mm read is retained as a secondary check
    (a ~20mm clear span exists along that axis). User also authorized
    cutting plastic to enlarge the space - the usable volume is defined
    by the cut study (remove UMD-only bracket/ribs/trough interior,
    preserve bosses/hinge/latch/perimeter/battery structure). U2 ->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
2026-10-15 40mm tape read confirmed: zero on the removed-drive cavity floor
    User confirmed: tape zero = cavity floor of the removed UMD drive
    site, 40mm straight-line span to the opening edge. Corroborates the
    scan's 50mm Y-opening chord geometry and confirms the floor is
    reachable at that axis (spindle mount / sled rails gone or below the
    insert path). U2 updated: SCAN-AUTHORITATIVE + donor corroboration +
    cut study authorized.
2026-10-15 cut study v1: 17 human-friendly cut pockets from the scan zmap
    cad/cut_study_v1.py extracts the rib/web material inside the cavity
    walls (1mm zmap), excludes boss disks +2mm and perimeter walls, and
    segments the cuttable web into straight 4mm-tall rectangular pockets
    - rotary-tool-friendly edges. 17 pockets, all 7.7mm deep (rim 8.73
    to floor 1.0). STEP export (pockets + OPi level-A envelope) and a
    top-view SVG cut map (red=pockets, blue=OPi, dash=cavity) for the
    human pass. Cut plan doc: grouped zones A-E, depth stops (7.7mm,
    tape-mark the burr), protected list, honest limits (1mm top-view
    grid misses undercuts; boss positions need per-unit verification).
    [umd_cut_study_v1.step]
